Mohamed-Tarek-18/OnAirAirship-/STR-MTM.-Airship.SLDASM

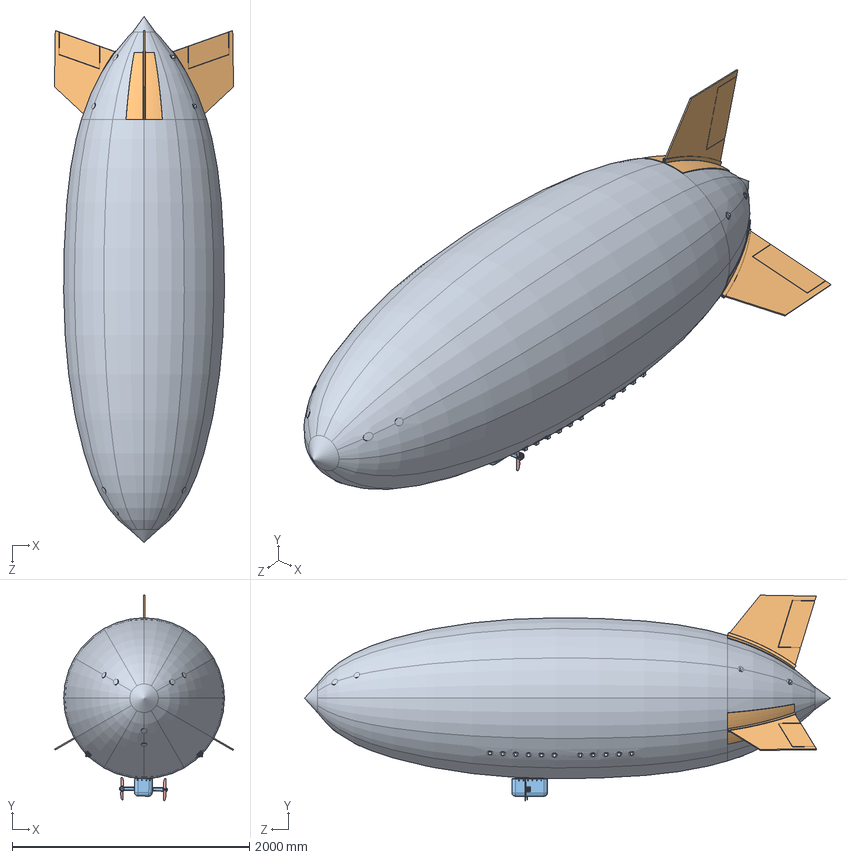
[picture p21: CAD file, 2023-03-06]
STR-MTM.-Airship.SLDASM
1511.0 x 1734.9 x 4437.0 mm
STR-MTM-Envelope1.2
STR-MYD-Tail_Fin-2.1 x 3
STR-MYD-Gondola-1.0
STR-MYD-Motor-1.0 x 2
STR-MYD-Fan-1.0 x 2
