Mohamed-Tarek-18/OnAirAirship-/STR-MYD-Ring.SLDPRT

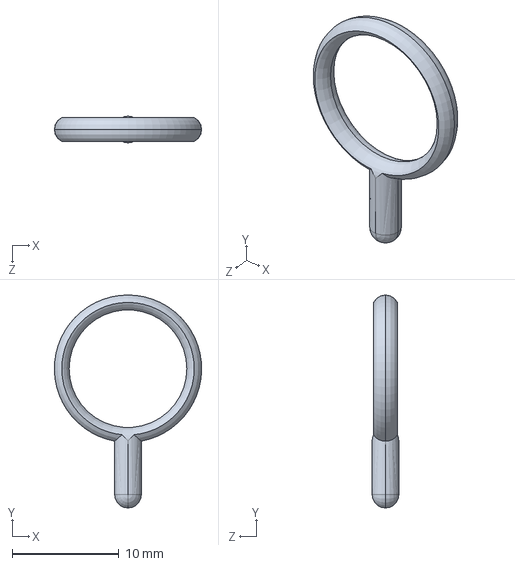
[picture p22: CAD file, 2023-03-06]
STR-MYD-Ring.SLDPRT
13.8 x 19.9 x 2.50 mm
