Mohamed-Tarek-18/OnAirAirship-/STR-MYD-Gondola-1.0.SLDPRT

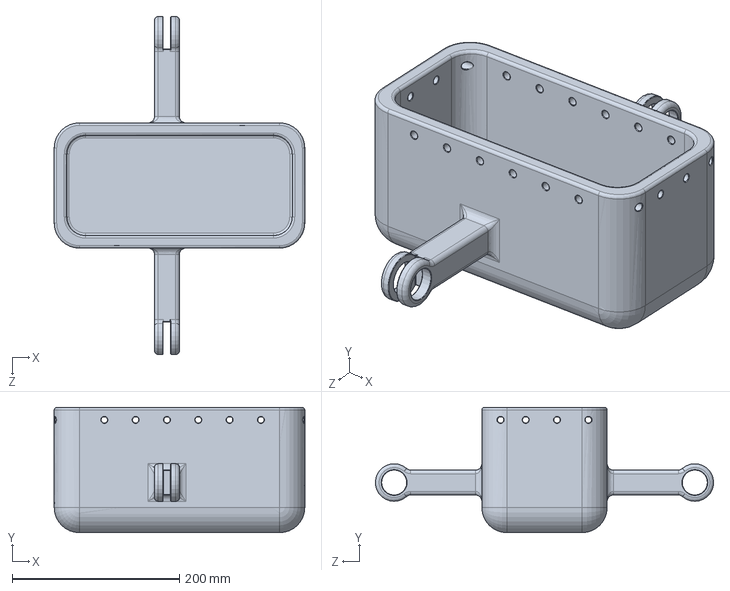
[picture p23: CAD file, 2023-03-06]
STR-MYD-Gondola-1.0.SLDPRT
300.0 x 150.0 x 404.7 mm
