Mohamed-Tarek-18/OnAirAirship-/STR-MYD-Motor-1.0.SLDPRT

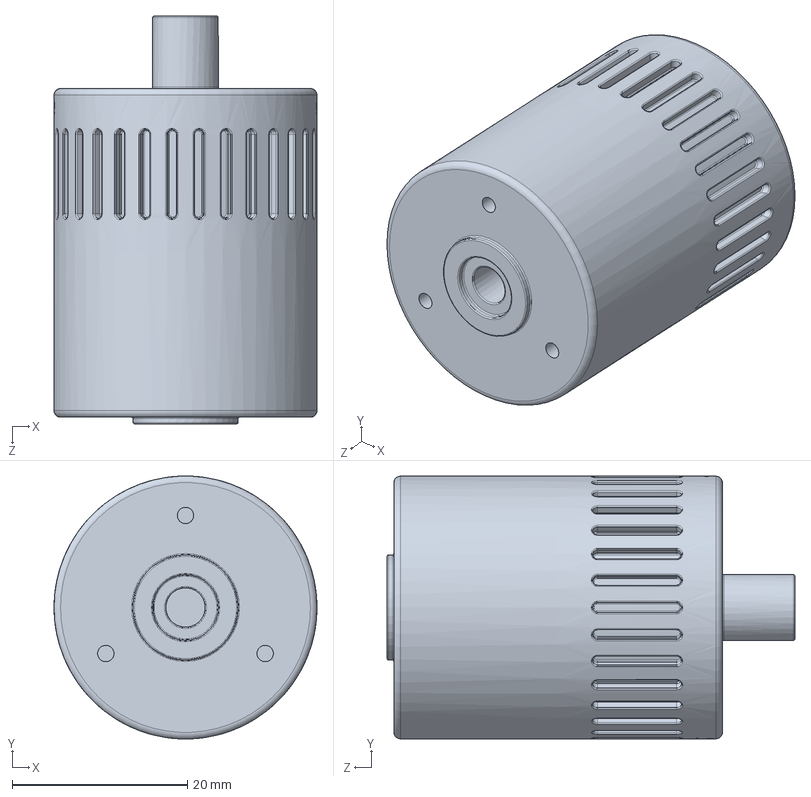
[picture p24: CAD file, 2023-03-06]
STR-MYD-Motor-1.0.SLDPRT
30.0 x 30.0 x 46.5 mm
