Mohamed-Tarek-18/OnAirAirship-/STR-MYD-Fan-1.0.SLDPRT

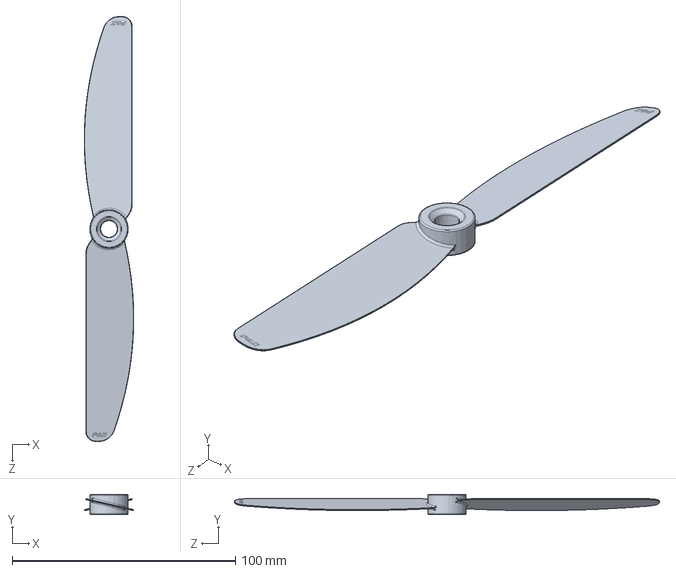
[picture p25: CAD file, 2023-03-06]
STR-MYD-Fan-1.0.SLDPRT
22.1 x 9.00 x 190.5 mm
