Mohamed-Tarek-18/OnAirAirship-/STR-MYD-Tail_Fin-2.1.SLDPRT

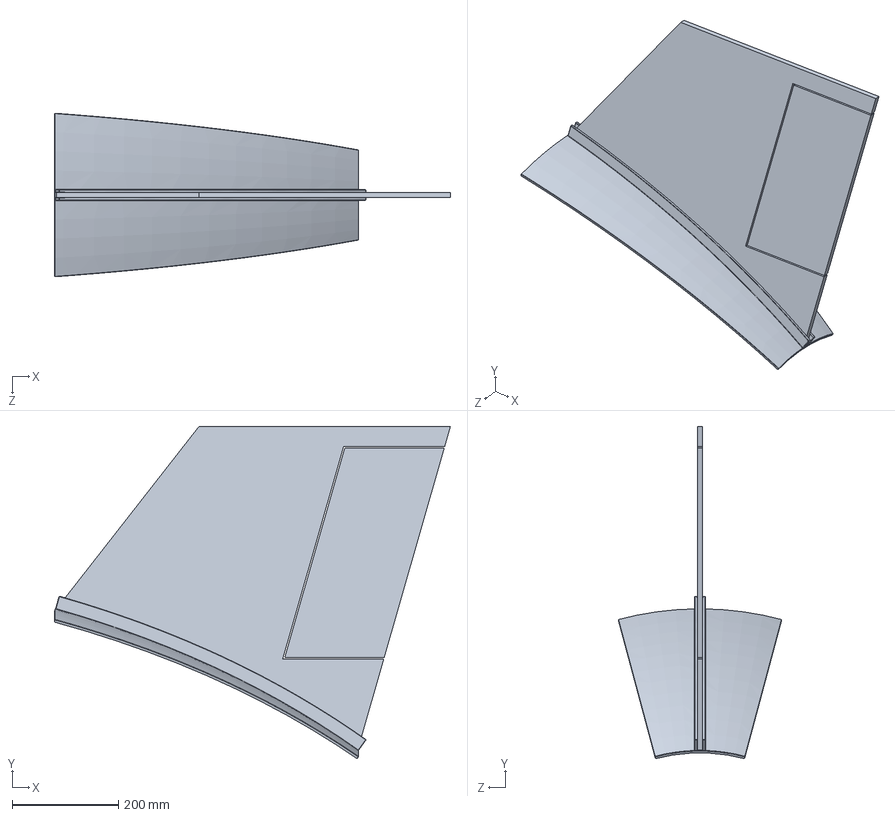
[picture p26: CAD file, 2023-03-06]
STR-MYD-Tail_Fin-2.1.SLDPRT
744.8 x 624.9 x 307.5 mm
